t-crest/s4noc/README

A Statically-Scheduled Time-Division-Multiplexed Network-on-Chip for Real-Time Systems

First experiments for a clocked NoC within the EC project T-CREST.
