t-crest/s4noc/noc/results/results.xlsx

Sheet: Dual clocked
 | Resources pr. tile |  |  |  |  |  | Period length | Fmax
 | Cores |  | NI | NI_ST | Router | Router_ST | Period length | Router (MHz) | Tile (MHz) | Remarks | Cores | NI:LUT | NI:Reg | NI:Blockram | Router:LUT | Router:Reg | NI_ST | Router_ST | Period
2x2 | 4 | LUT | 86 | 4 | 44 | 4 | 5 | 207 | 103 | Because the network is 2x2 it is not really a torus and therefore the router is smaller | 4 | 86 | 64 | 0.256 | 44 | 100 | 80 | 80 | 5
 |  | Registers | 64 |  | 100 |  |  |  |  |  | 9 | 162 | 98 | 0.512 | 122 | 107 | 60 | 120 | 10
 |  | Ram bits | 256 |  |  |  |  |  |  |  | 16 | 183 | 109 | 0.512 | 108 | 105 | 94.73684211 | 100 | 19
3x3 | 9 | LUT | 162 | 6 | 122 | 12 | 10 | 210 | 104 | Final | 25 | 250 | 138 | 1.024 | 121 | 106 | 103.7037037 | 85.18518519 | 27
 |  | Registers | 98 | 0 | 107 | 0 |  |  |  |  | 36 | 347 | 194 | 2.048 | 138 | 107 | 111.9047619 | 92.85714286 | 42
 |  | Ram bits | 512 | 0 | 0 | 0 |  |  |  |  | 49 | 449 | 248 | 2.048 | 149 | 107 | 120.6896552 | 86.20689655 | 58
4x4 | 16 | LUT | 183 | 18 | 108 | 19 | 19 | 206 | 118 | New measurement | 64 | 579 | 307 | 2.048 | 181 | 108 | 136.7816092 | 93.10344828 | 87
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
