t-crest/s4noc/noc/vhdl/ni.vhd

--
--  Copyright 2012 Rasmus Bo Soerensen <rasmus@rbscloud.dk>,
--                 Technical University of Denmark, DTU Informatics. 
--  All rights reserved.
--
-- Redistribution and use in source and binary forms, with or without
-- modification, are permitted provided that the following conditions are met:
-- 
--    1. Redistributions of source code must retain the above copyright notice,
--       this list of conditions and the following disclaimer.
-- 
--    2. Redistributions in binary form must reproduce the above copyright
--       notice, this list of conditions and the following disclaimer in the
--       documentation and/or other materials provided with the distribution.
-- 
-- THIS SOFTWARE IS PROVIDED BY THE COPYRIGHT HOLDER ``AS IS'' AND ANY EXPRESS
-- OR IMPLIED WARRANTIES, INCLUDING, BUT NOT LIMITED TO, THE IMPLIED WARRANTIES
-- OF MERCHANTABILITY AND FITNESS FOR A PARTICULAR PURPOSE ARE DISCLAIMED. IN
-- NO EVENT SHALL THE COPYRIGHT HOLDER OR CONTRIBUTORS BE LIABLE FOR ANY
-- DIRECT, INDIRECT, INCIDENTAL, SPECIAL, EXEMPLARY, OR CONSEQUENTIAL DAMAGES
-- (INCLUDING, BUT NOT LIMITED TO, PROCUREMENT OF SUBSTITUTE GOODS OR SERVICES;
-- LOSS OF USE, DATA, OR PROFITS; OR BUSINESS INTERRUPTION) HOWEVER CAUSED AND
-- ON ANY THEORY OF LIABILITY, WHETHER IN CONTRACT, STRICT LIABILITY, OR TORT
-- (INCLUDING NEGLIGENCE OR OTHERWISE) ARISING IN ANY WAY OUT OF THE USE OF
-- THIS SOFTWARE, EVEN IF ADVISED OF THE POSSIBILITY OF SUCH DAMAGE.
-- 
-- The views and conclusions contained in the software and documentation are
-- those of the authors and should not be interpreted as representing official
-- policies, either expressed or implied, of the copyright holder.
--
--

library ieee;
use ieee.numeric_std.all;
use ieee.std_logic_1164.all;
use work.leros_types.all;
use work.noc_types.all;

entity ni is
  generic (
    TOTAL_NI_NUM  : natural;
    NI_NUM        : natural;
    stable_length : natural);           -- The slot table length should be
  -- modified to fit the NoC.
  port (
    router_clk    : in  std_logic;
    processor_clk : in  std_logic;
    reset         : in  std_logic;
    -- Signals to/from the router
    tile_tx_f     : out network_link_forward;
    tile_tx_b     : in  network_link_backward;
    tile_rx_f     : in  network_link_forward;
    tile_rx_b     : out network_link_backward;
    -- Signals to/from the tile
    processor_out : in  io_out_type;
    processor_in  : out io_in_type);

end ni;

architecture behav of ni is
  signal count                       : unsigned(log2(stable_length) downto 0);  -- Count to
                                        -- describe the
                                        -- slot number.
  signal tx_reg, tx_out              : tile_word;  -- Register to save data word from tile.
  signal tx_addr                     : tile_address;  -- Register to save address from the tile.
  signal tx_rdy                      : std_logic;  -- Signal indicating that the correct slot
  -- is reached and the tile_word is now sent.
  signal rx_reg, rx_in               : tile_word;  -- Signal representing an entire network flit.
  signal rx_clr, rx_rdy              : std_logic;  -- Signals for clearing and setting the rx_register
  signal status_reg, next_status_reg : std_logic_vector(15 downto 0);  -- Status register for communicating to the tile.
  signal tx_slot_dest, rx_slot_src   : integer range 0 to TOTAL_NI_NUM;
  signal dest_reg, src_reg           : integer range 0 to TOTAL_NI_NUM;
  
begin  -- behav

-------------------------------------------------------------------------------
-- Counter for keeping track of the timeslot number
-------------------------------------------------------------------------------
  
  counter : process (processor_clk, reset)
  begin  -- process count
    if reset = '1' then                    -- asynchronous reset (active high)
--      count <= to_unsigned(1,log2(stable_length)+1);
      count <= (others => '0');
    elsif rising_edge(processor_clk) then  -- rising clock edge
      if count < stable_length-1 then
        count <= count + to_unsigned(1, 1);
      else
        count <= (others => '0');
      end if;

    end if;
  end process counter;

-------------------------------------------------------------------------------
-- Serialize/deserialize or atomize/deatomize
-------------------------------------------------------------------------------

  serdes : entity work.serdes
    generic map (
      tile_width => tile_word'length,
      ratio_clk  => NETWORK_PHITS_PR_FLIT)
    port map (
      fast_clk     => router_clk,
      slow_clk     => processor_clk,
      reset        => reset,
      serial_in    => tile_rx_f.data,
      parallel_in  => tx_out,
      serial_out   => tile_tx_f.data,
      parallel_out => rx_in);

-------------------------------------------------------------------------------
-- Transmit channel
-------------------------------------------------------------------------------
  
  tx_register : process (processor_clk, reset)
  begin  -- process tx_reg
    if reset = '1' then
      tx_reg  <= (others => '0');
      tx_addr <= (others => '0');
    elsif rising_edge(processor_clk) then  -- rising clock edge
      if processor_out.wr = '1' then
        tx_reg  <= processor_out.wrdata;
        tx_addr <= processor_out.addr;
      elsif tx_rdy = '1' then
        tx_reg  <= (others => '0');
        tx_addr <= (others => '0');
      else
        tx_reg  <= tx_reg;
        tx_addr <= tx_addr;
      end if;
    end if;
  end process tx_register;

  tx_data : process (tx_rdy, tx_reg)
  begin  -- process
    if tx_rdy = '1' then
      tx_out <= tx_reg;
    else
      tx_out <= (others => '0');
    end if;
    
  end process tx_data;

-------------------------------------------------------------------------------
-- Receive channel
-------------------------------------------------------------------------------

  rx_register : process (processor_clk, reset)
  begin  -- process rx_register
    if reset = '1' then
      rx_reg <= (others => '0');
    elsif rising_edge(processor_clk) then  -- rising clock edge
      if rx_rdy = '1' then
        rx_reg <= rx_in;
      elsif rx_clr = '1' then
        rx_reg <= (others => '0');
      else
        rx_reg <= rx_reg;
      end if;
    end if;
  end process rx_register;

  rx_data : process (processor_out, rx_reg, status_reg)
  begin  -- process out_data
    rx_clr <= '0';
    if processor_out.rd = '1' then
      if processor_out.addr(7) = '1' then
        processor_in.rddata <= status_reg;
      else
        processor_in.rddata <= rx_reg;
        rx_clr              <= '1';
      end if;
    else
      processor_in.rddata <= (others => '0');
    end if;
  end process rx_data;

-------------------------------------------------------------------------------
-- Control logic & update of the status register
-------------------------------------------------------------------------------

  control : process (tx_rdy, rx_rdy, processor_out.wr, rx_clr, status_reg)
    variable rx_status : std_logic;
    variable rx_error  : std_logic;
    variable tx_status : std_logic;
    variable tx_error  : std_logic;
  begin  -- process control
    rx_status := status_reg(4);
    rx_error  := '0';
    tx_status := status_reg(0);
    tx_error  := '0';
    if (rx_rdy = '0' and rx_clr = '0' and rx_status = '0') or
      (rx_rdy = '0' and rx_clr = '1' and rx_status = '1') then
      rx_status := '0';
      rx_error  := '0';
    elsif (rx_rdy = '0' and rx_clr = '1' and rx_status = '0') then
      rx_status := '0';
      rx_error  := '1';
    elsif (rx_rdy = '1' and rx_clr = '1' and rx_status = '0') or
      (rx_rdy = '1' and rx_clr = '0' and rx_status = '1') then
      rx_status := '1';
      rx_error  := '1';
    elsif (rx_rdy = '0' and rx_clr = '0' and rx_status = '1') or
      (rx_rdy = '1' and rx_clr = '0' and rx_status = '0') or
      (rx_rdy = '1' and rx_clr = '1' and rx_status = '1') then
      rx_status := '1';
      rx_error  := '0';
    end if;

    if (tx_rdy = '0' and processor_out.wr = '0' and tx_status = '0') or
      (tx_rdy = '1' and processor_out.wr = '0' and tx_status = '0') or
      (tx_rdy = '1' and processor_out.wr = '0' and tx_status = '1') then
      tx_status := '0';
      tx_error  := '0';
    elsif (tx_rdy = '0' and processor_out.wr = '1' and tx_status = '1') then
      tx_status := '1';
      tx_error  := '1';
    elsif (tx_rdy = '0' and processor_out.wr = '0' and tx_status = '1') or
      (tx_rdy = '0' and processor_out.wr = '1' and tx_status = '0') or
      (tx_rdy = '1' and processor_out.wr = '1' and tx_status = '0') or
      (tx_rdy = '1' and processor_out.wr = '1' and tx_status = '1') then
      tx_status := '1';
      tx_error  := '0';
    end if;

    next_status_reg    <= (others => '0');
    next_status_reg(7) <= rx_error;
    next_status_reg(4) <= rx_status;
    next_status_reg(3) <= tx_error;
    next_status_reg(0) <= tx_status;

    if tx_error = '1' and rx_error = '1' then
      next_status_reg(15 downto 8) <= std_logic_vector(unsigned(status_reg(15 downto 8)) + to_unsigned(2, 2));
    elsif tx_error = '1' xor rx_error = '1' then
      next_status_reg(15 downto 8) <= std_logic_vector(unsigned(status_reg(15 downto 8)) + to_unsigned(1, 2));
    else
      next_status_reg(15 downto 8) <= status_reg(15 downto 8);
    end if;
    
  end process control;

  status_register : process (processor_clk, reset)
  begin  -- process status_register
    if reset = '1' then                    -- asynchronous reset (active high)
      status_reg <= (others => '0');
    elsif rising_edge(processor_clk) then  -- rising clock edge
      status_reg <= next_status_reg;
    end if;
  end process status_register;

-------------------------------------------------------------------------------
-- Slot tables.
-------------------------------------------------------------------------------

  ni_ST : entity work.ni_ST
    generic map (
      NI_NUM => NI_NUM)
    port map (
      count => count,
      dest  => dest_reg,
      src   => src_reg);

  slot_regs : process (processor_clk, reset)
  begin  -- process slot_regs
    if reset = '1' then                    -- asynchronous reset (active high)
      tx_slot_dest <= 0;
      rx_slot_src  <= 0;
    elsif rising_edge(processor_clk) then  -- rising clock edge
      tx_slot_dest <= dest_reg;
      rx_slot_src  <= src_reg;
    end if;
  end process slot_regs;


  tx_stable : process (tx_slot_dest, status_reg, tx_addr)
  begin  -- process tx_stable
    if to_unsigned(tx_slot_dest, log2(TOTAL_NI_NUM)+1) = unsigned(tx_addr(log2(TOTAL_NI_NUM)+1 downto 0)) then
--      if std_logic_vector(count(1 downto 0)) = "01" then
      tx_rdy               <= '1';
      tile_tx_f.data_valid <= status_reg(0);
    else
      tx_rdy               <= '0';
      tile_tx_f.data_valid <= '0';
    end if;
--    end if;
  end process tx_stable;



  rx_stable : process (tile_rx_f.data_valid, rx_slot_src)
  begin  -- process rx_stable
--    if to_unsigned(rx_slot_src, log2(TOTAL_NI_NUM)) = unsigned(tx_addr(log2(TOTAL_NI_NUM) downto 0)) then
    if tile_rx_f.data_valid = '1' then
      rx_rdy <= '1';
    else
      rx_rdy <= '0';
    end if;
--    end if;
  end process rx_stable;

end behav;
