t-crest/s4noc/noc-sched/src/ilp-schedule.cc

//
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

#include "noc.h"

#include <ostream>

#ifndef NDEBUG
std::set<std::string> ILP_names;
#endif

/// Get the name of the ILP variable for a link, a destination node, and a
/// cycle.
/// @param l The link.
/// @param d The destination node.
/// @param c The cycle.
static void el_(const link_t &l, const node_t &d, unsigned int c,
                std::ostream &os)
{
  os << l << "____" << d << "____" << c;
}

/// Get the name of the ILP variable for a link, a destination node, and a
/// cycle.
/// @param l The link.
/// @param d The destination node.
/// @param c The cycle.
static void el(const link_t &l, const node_t &d, unsigned int c,
               std::ostream &os)
{
  el_(l, d, c, os);

#ifndef NDEBUG
  const node_t &ls(l.get_source());
  const node_t &ld(l.get_destination());

  assert(ls.is_router() || &ls != &d);
  assert(ld.is_router() || &ld == &d);

  std::stringstream s;
  el_(l, d, c, s);
  
  assert(ILP_names.find(s.str()) != ILP_names.end());
#endif
}

/// Print ILP equations to derive a routing schedule for the NoC.
/// @param os An output stream to write the equations to.
/// @param noc An instance of a given NoC (topology).
/// @param bound An upper bound on the schedule length (depending on the NoC
/// topology)
void print_lp(std::ostream &os, const noc_t &noc, unsigned int bound)
{
  const nodes_t &N = noc.get_nodes();
  const links_t &L = noc.get_links();

  // count non-router nodes
  unsigned int non_router = 0;
  for(nodes_t::const_iterator d(N.begin()), de(N.end());d != de; d++)
  {
    if (!(*d)->is_router())
    {
      non_router++;
    }
  }

  unsigned int MAXC = bound;

  // count constraints
  unsigned int cnt = 0;

  // make a list of all valid ILP variable names appearing in the equations.
#ifndef NDEBUG
  for(links_t::const_iterator l(L.begin()), le(L.end()); l != le; l++)
  {
    const node_t &ls((*l)->get_source());
    const node_t &ld((*l)->get_destination());

    for(nodes_t::const_iterator d(N.begin()), de(N.end());d != de; d++)
    {
      if ((ls.is_router() || &ls != *d) &&
          (ld.is_router() || &ld == *d) &&
          !(*d)->is_router())
      {
        for(unsigned int c = 0; c != MAXC + 1; c++)
        {
          std::stringstream s;
          el_(**l, **d, c, s);
          ILP_names.insert(s.str());
        }
      }
    }
  }
#endif
  os << "Minimize\ncycles\n";

  for(links_t::const_iterator l(L.begin()), le(L.end()); l != le; l++)
  {
    const node_t &ls((*l)->get_source());
    const node_t &ld((*l)->get_destination());

    for(nodes_t::const_iterator d(N.begin()), de(N.end());d != de; d++)
    {
      if ((ls.is_router() || &ls != *d) &&
          (ld.is_router() || &ld == *d) &&
          !(*d)->is_router())
      {
        for(unsigned int c = 0; c != MAXC + 1; c++)
        {
          os << " + " << 1.0/(L.size()*non_router*MAXC) << " ";
          el_(**l, **d, c, os);
        }
        os << "\n";
      }
    }
  }

  os << "\n\nSubject To\n";

  // derive the last cycle with an active link.
  for(unsigned int c = 1; c != MAXC + 1; c++)
  {
    os << "c" << cnt++ << ":\t" << non_router << " cycle_" << c;

    for(links_t::const_iterator l(L.begin()), le(L.end()); l != le; l++)
    {
      const node_t &ld((*l)->get_destination());

      // a link to a non-router node
      if (!ld.is_router())
      {
        os << " - ";
        el(**l, ld, c, os);
      }
    }
    os << " >= 0\n";

    os << "c" << cnt++ << ":\tcycles - " << c << " cycle_" << c << " >= 0\n";
  }

  // ensure that routers never produce values out of nothing at cycle 0
  for(links_t::const_iterator l(L.begin()), le(L.end()); l != le; l++)
  {
    const node_t &ls((*l)->get_source());
    const node_t &ld((*l)->get_destination());

    // do not constrain the ILP variables for non-router nodes, since they
    // can produce values at any moment
    if (ls.is_router())
    {
      for(nodes_t::const_iterator d(N.begin()), de(N.end());d != de; d++)
      {
        if ((ld.is_router() || &ld == *d) &&
            !(*d)->is_router())
        {
          // ensure that routers never produce values out of nothing at cycle 0
          os << "i" << cnt++ << ":\t";
          el(**l, **d, 0, os);
          os << " = 0\n";
        }
      }
    }
  }

  // preserve in- and out-going flow at routers on every cycle
  // find all router
  for(nodes_t::const_iterator r(N.begin()), re(N.end());r != re; r++)
  {
    if ((*r)->is_router())
    {
      for(nodes_t::const_iterator d(N.begin()), de(N.end());d != de; d++)
      {
        if (!(*d)->is_router())
        {
          for(unsigned int c = 0; c != MAXC; c++)
          {
            os << "f" << cnt++ << ":\t";

            for(links_t::const_iterator l(L.begin()), le(L.end()); l != le; l++)
            {
              const node_t &ls((*l)->get_source());
              const node_t &ld((*l)->get_destination());

              // a link to/from the router
              if (&ls == *r || &ld == *r)
              {
                if ((ls.is_router() || &ls != *d) &&
                    (ld.is_router() || &ld == *d))
                {
                  // sum out-flow
                  if (&ls == *r)
                  {
                    os << " + ";
                    el(**l, **d, c + 1, os);
                  }
                  // subtract in-flow
                  if (&ld == *r)
                  {
                    os << " - ";
                    el(**l, **d, c, os);
                  }
                }
              }
            }

            // in-flow and out-flow have to match
            os << " = 0\n";
          }
        }
      }
    }
  }

  // restrict each link to one message per cycle
  for(unsigned int c = 0; c != MAXC + 1; c++)
  {
    for(links_t::const_iterator l(L.begin()), le(L.end()); l != le; l++)
    {
      const node_t &ls((*l)->get_source());
      const node_t &ld((*l)->get_destination());

      os << "u" << cnt++ << ":\t";

      for(nodes_t::const_iterator d(N.begin()), de(N.end());d != de; d++)
      {
        if ((ls.is_router() || &ls != *d) &&
            (ld.is_router() || &ld == *d) &&
            !(*d)->is_router())
        {
          os << " + ";
          el(**l, **d, c, os);
        }
      }

      os << " <= 1\n";
    }
  }

  // ensure that every node receives a message from every other node
  for(links_t::const_iterator l(L.begin()), le(L.end()); l != le; l++)
  {
    const node_t &ld((*l)->get_destination());

    // a link to a non-router node
    if (!ld.is_router())
    {
      // consider all communications over this links leading to the non-router
      // node over all cycles
      os << "r" << cnt++ << ":\t";
      for(unsigned int c = 0; c != MAXC + 1; c++)
      {
        os << " + ";
        el(**l, ld, c, os);
      }

      os << " = " << (non_router - 1) << "\n";
    }
  }

  // ensure that every node sends once to every other node
  for(links_t::const_iterator l(L.begin()), le(L.end()); l != le; l++)
  {
    const node_t &ls((*l)->get_source());

    // a link from a non-router node
    if (!ls.is_router())
    {
      for(nodes_t::const_iterator d(N.begin()), de(N.end());d != de; d++)
      {
        // only send to other non-router nodes
        if (*d != &ls && !(*d)->is_router())
        {
          // disallow sending messages in the last cycle
          os << "n" << cnt++ << ":\t";
          el(**l, **d, MAXC, os);
          os << " = 0\n";

          // consider all links leading from the non-router node to the
          // destination.
          os << "s" << cnt++ << ":\t";
          for(unsigned int c = 0; c != MAXC; c++)
          {
            os << " + ";
            el(**l, **d, c, os);
          }

          os << " = 1\n";
        }
      }
    }
  }

  // // // // // // // // // // // // // // // // // // // // // // // // // //
  os << "\n\nBounds\n";
  os << (non_router - 1) << " <= cycles <= " << (non_router*non_router) << "\n";

  // // // // // // // // // // // // // // // // // // // // // // // // // //
  os << "\n\nBinaries\n";
  for(links_t::const_iterator l(L.begin()), le(L.end()); l != le; l++)
  {
    const node_t &ls((*l)->get_source());
    const node_t &ld((*l)->get_destination());

    for(nodes_t::const_iterator d(N.begin()), de(N.end());d != de; d++)
    {
      if ((ls.is_router() || &ls != *d) &&
          (ld.is_router() || &ld == *d) &
          !(*d)->is_router())
      {
        for(unsigned int c = 0; c != MAXC + 1; c++)
        {
          el(**l, **d, c, os);
          os << "\n";
        }
      }
    }
  }

  for(unsigned int c = 1; c != MAXC + 1; c++)
  {
    os << "cycle_" << c << "\n";
  }

  os << "Generals\ncycles\n";
  os << "End\n";
}
