t-crest/s4noc/noc/vhdl/dp_ram.vhd

-- Quartus II VHDL Template
-- True Dual-Port RAM with single clock
--
-- Read-during-write on port A or B returns newly written data
-- 
-- Read-during-write between A and B returns either new or old data depending
-- on the order in which the simulator executes the process statements.
-- Quartus II will consider this read-during-write scenario as a 
-- don't care condition to optimize the performance of the RAM.  If you
-- need a read-during-write between ports to return the old data, you
-- must instantiate the altsyncram Megafunction directly.

library ieee;
use ieee.std_logic_1164.all;

entity dp_ram is

  generic
    (
      DATA_WIDTH : natural := 8;
      ADDR_WIDTH : natural := 6
      );

  port
    (
      clk    : in  std_logic;
      addr_a : in  natural range 0 to 2**ADDR_WIDTH - 1;
      addr_b : in  natural range 0 to 2**ADDR_WIDTH - 1;
      data_a : in  std_logic_vector((DATA_WIDTH-1) downto 0);
      data_b : in  std_logic_vector((DATA_WIDTH-1) downto 0);
      we_a   : in  std_logic := '1';
      we_b   : in  std_logic := '1';
      q_a    : out std_logic_vector((DATA_WIDTH -1) downto 0);
      q_b    : out std_logic_vector((DATA_WIDTH -1) downto 0)
      );

end dp_ram;

architecture rtl of dp_ram is

  -- Build a 2-D array type for the RAM
  subtype word_t is std_logic_vector((DATA_WIDTH-1) downto 0);
  type    memory_t is array(2**ADDR_WIDTH-1 downto 0) of word_t;

  -- Declare the RAM 
  shared variable ram : memory_t;

begin


  -- Port A
  process(clk)
  begin
    if(rising_edge(clk)) then
      if(we_a = '1') then
        ram(addr_a) := data_a;
      end if;
      q_a <= ram(addr_a);
    end if;
  end process;

  -- Port B 
  process(clk)
  begin
    if(rising_edge(clk)) then
      if(we_b = '1') then
        ram(addr_b) := data_b;
      end if;
      q_b <= ram(addr_b);
    end if;
  end process;

end rtl;
