t-crest/s4noc/(commit log)

2012-02-03 * allow printing of time and network configuration * three heuristic configurations to select candidates during scheduling * scripts to run experiments for heuristic and extract tables
2012-02-06 * option to choose shortest patterns during candidate selection
    [heuristic.h, main.cc, pattern-schedule.cc]
2012-02-16 The initial Network Interface (NI): Done: Different clock speeds on each side on the NI. One channel single register read/write. Missing: Implementing the static schedule in the NI and the node. Buff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
    [ni.vhd, ni_types.vhd, serdes.vhd, tb_NI.vhd]
2012-02-20 The Network Interface is simulating and synthesising, still missing routing tables. Small testbench added, testing two tiles one with a UART. TEST is NOT done yet.
    [ni.vhd, noc_N.vhd, noc_node.vhd, noc_types.vhd, outnode.vhd, router.vhd, serdes.vhd, tb_NI.vhd]
2012-03-20 Design is now synthsising.
    [results.xlsx]
2012-03-23 Schedule tables updated and reset synchronized. Still not running Noc_test.java in the FPGA.
    [results.xlsx]
2012-03-29 New measurements added in Results.xlsx
    [results.xlsx]
2012-06-21 Noc_test.asm repeatedly writes an A to the UART when done.
2012-06-21 NoC tested and working in the FPGA. The Noc_test.asm prints " ELLO T-CREST!" The H is missing. Software bug.
    [tile.vhd]
2012-08-22 New results for the single clocked network adapter.
    [results.xlsx]
2012-08-23 Results updated.
    [results.xlsx]
2012-08-23 Updated results.
    [results.xlsx]
